a6c0424fa083/LightController_PCB/README.md

# LightController_PCB
This is the PCB (designed in KiCad) used in the LightController software
