a6c0424fa083/LightController_PCB/Projects/DMX-Adapter-small-V3/DMX-Adapter-small-V3.kicad_pcb

## KiCad design Projects/DMX-Adapter-small-V3/DMX-Adapter-small-V3.kicad_pcb (2025-03-28)

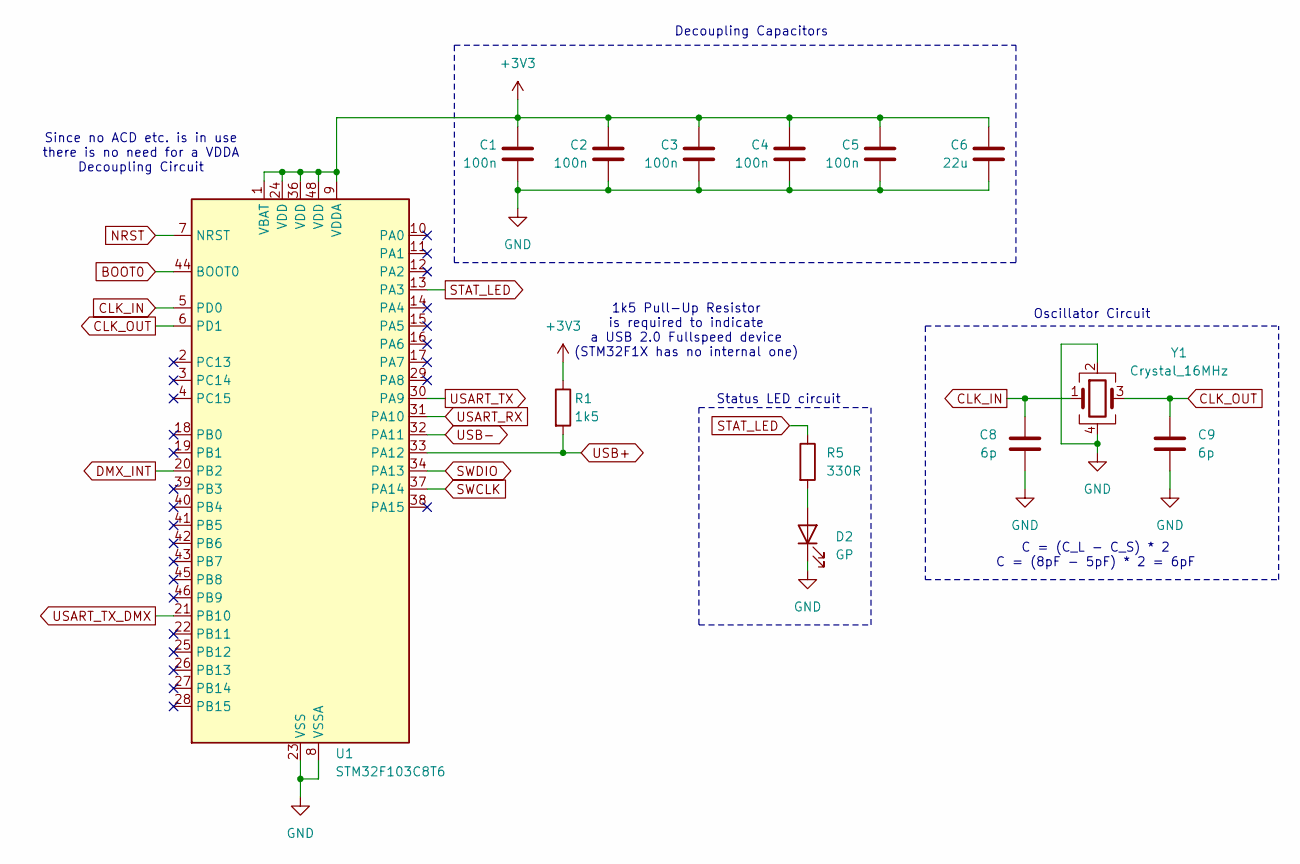
[picture p1: schematic mcu.kicad_sch]

Parts:
C1, C2, C3, C4, C5: 100n; C_0402_1005Metric; Mouser-Nr 81-GRM152D70G104ME5D
C6: 22u; C_0603_1608Metric; Mouser-Nr 81-GRM188C80J226ME5D
C8, C9: 6p; C_0402_1005Metric; Mouser-Nr 81-GCQ1555C1H6R0BB1D
D2: GP; D_0603_1608Metric; Mouser-Nr 755-SML-D12V8WT86
R1: 1k5; R_0402_1005Metric; Mouser-Nr 667-ERA-2VEB1501X
R5: 330R; R_0402_1005Metric; Mouser-Nr 71-CRCW0402330RFKEDH
U1: STM32F103C8T6; LQFP-48_7x7mm_P0.5mm; Mouser-Nr 511-STM32F103C8T6
Y1: Crystal_16MHz; Crystal_Wuerth_830108207109; Mouser-Nr 710-830108207109

Connections:
+3V3: C1.1, C2.1, C3.1, C4.1, C5.1, C6.1, R1.1, U1.1 (VBAT), U1.9 (VDDA), U1.24 (VDD), U1.36 (VDD), U1.48 (VDD); also elsewhere on the board
BOOT0: U1.44 (BOOT0); also elsewhere on the board
CLK_IN: C8.1, U1.5 (PD0), Y1.1
CLK_OUT: C9.1, U1.6 (PD1), Y1.3
DMX_INT: U1.20 (PB2); also elsewhere on the board
GND: C1.2, C2.2, C3.2, C4.2, C5.2, C6.2, C8.2, C9.2, D2.1 (K), U1.8 (VSSA), U1.23 (VSS), U1.35 (VSS), U1.47 (VSS), Y1.2, Y1.4; also elsewhere on the board
NRST: U1.7 (NRST); also elsewhere on the board
unnamed: D2.2 (A), R5.2
STAT_LED: R5.1, U1.13 (PA3)
SWCLK: U1.37 (PA14); also elsewhere on the board
SWDIO: U1.34 (PA13); also elsewhere on the board
USART_RX: U1.31 (PA10); also elsewhere on the board
USART_TX: U1.30 (PA9); also elsewhere on the board
USART_TX_DMX: U1.21 (PB10); also elsewhere on the board
USB+: R1.2, U1.33 (PA12); also elsewhere on the board
USB-: U1.32 (PA11); also elsewhere on the board

Notes on the sheet:
Status LED circuit
1k5 Pull-Up Resistor is required to indicate a USB 2.0 Fullspeed device (STM32F1X has no internal one)
Oscillator Circuit
Decoupling Capacitors
C = (C_L - C_S) * 2 C = (8pF - 5pF) * 2 = 6pF
Since no ACD etc. is in use there is no need for a VDDA Decoupling Circuit

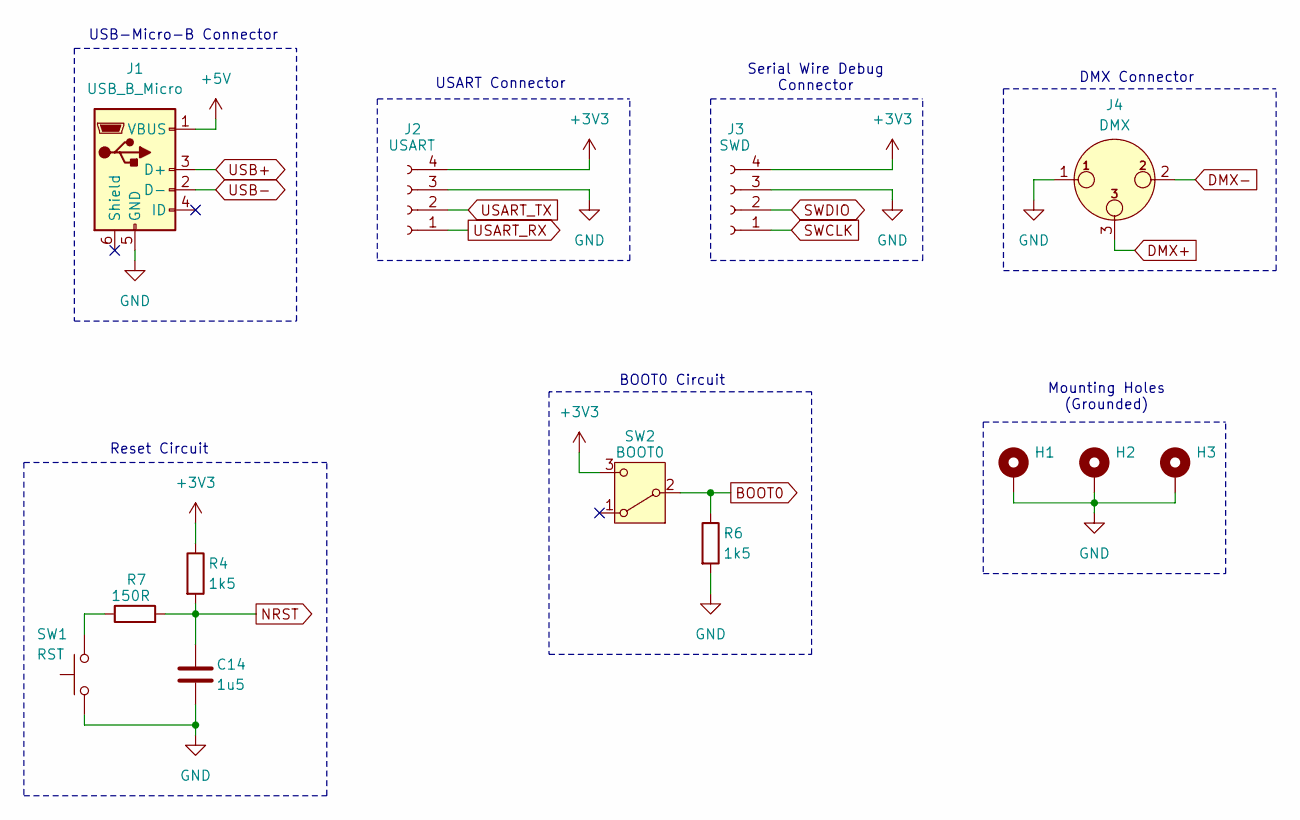
[picture p2: schematic connectors_io.kicad_sch, Connectors & IO]

Parts:
C14: 1u5; C_0603_1608Metric; Mouser-Nr 810-C1608X8L0J155K08
H1, H2, H3: MountingHole_Pad; MountingHole_2.2mm_M2_Pad
J1: USB_B_Micro; USB_Micro-B_Wuerth_629105150521; Mouser-Nr 710-629105150521
J2: USART; PinSocket_1x04_P2.54mm_Vertical; Mouser-Nr 710-61300411821
J3: SWD; PinSocket_1x04_P2.54mm_Vertical; Mouser-Nr 710-61300411821
J4: DMX; XLR3_Female; Mouser-Nr 568-NC3FAAH-1
R4, R6: 1k5; R_0402_1005Metric; Mouser-Nr 667-ERA-2VEB1501X
R7: 150R; R_0402_1005Metric; Mouser-Nr 660-SG73P1EWTTP151J
SW1: RST; omron_B3U-1000P; Mouser-Nr 653-B3U-1000P
SW2: BOOT0; wuerth_slide_switch_450404015514; Mouser-Nr 710-450404015514

Connections:
+3V3: J2.4, J3.4, R4.1, SW2.3 (C); also elsewhere on the board
+5V: J1.1 (VBUS); also elsewhere on the board
BOOT0: R6.1, SW2.2 (B); also elsewhere on the board
DMX+: J4.3; also elsewhere on the board
DMX-: J4.2; also elsewhere on the board
GND: C14.2, H1.1, H2.1, H3.1, J1.5 (GND), J2.3, J3.3, J4.1, R6.2, SW1.1; also elsewhere on the board
NRST: C14.1, R4.2, R7.2; also elsewhere on the board
unnamed: R7.1, SW1.2
SWCLK: J3.1; also elsewhere on the board
SWDIO: J3.2; also elsewhere on the board
USART_RX: J2.1; also elsewhere on the board
USART_TX: J2.2; also elsewhere on the board
USB+: J1.3 (D+); also elsewhere on the board
USB-: J1.2 (D-); also elsewhere on the board

Notes on the sheet:
Reset Circuit
USART Connector
USB-Micro-B Connector
Serial Wire Debug Connector
Mounting Holes (Grounded)
DMX Connector
BOOT0 Circuit

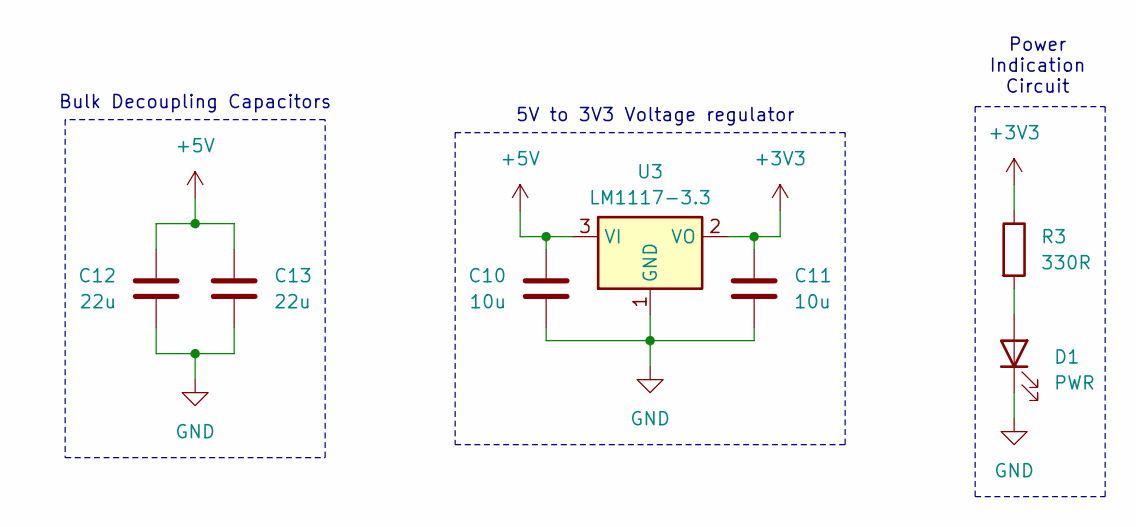
[picture p3: schematic power.kicad_sch]

Parts:
C10, C11: 10u; C_0805_2012Metric; Mouser-Nr 581-TACR106M006RTA
C12, C13: 22u; C_0603_1608Metric; Mouser-Nr 81-GRM188C80J226ME5D
D1: PWR; D_0603_1608Metric; Mouser-Nr 755-SML-D12V8WT86
R3: 330R; R_0402_1005Metric; Mouser-Nr 71-CRCW0402330RFKEDH
U3: LM1117-3.3; SOT-223-3_TabPin2; Mouser-Nr 926-LM1117IMPX33NOPB

Connections:
+3V3: C11.1, R3.1, U3.2 (VO); also elsewhere on the board
+5V: C10.1, C12.1, C13.1, U3.3 (VI); also elsewhere on the board
GND: C10.2, C11.2, C12.2, C13.2, D1.1 (K), U3.1 (GND); also elsewhere on the board
unnamed: D1.2 (A), R3.2

Notes on the sheet:
Power Indication Circuit
5V to 3V3 Voltage regulator
Bulk Decoupling Capacitors

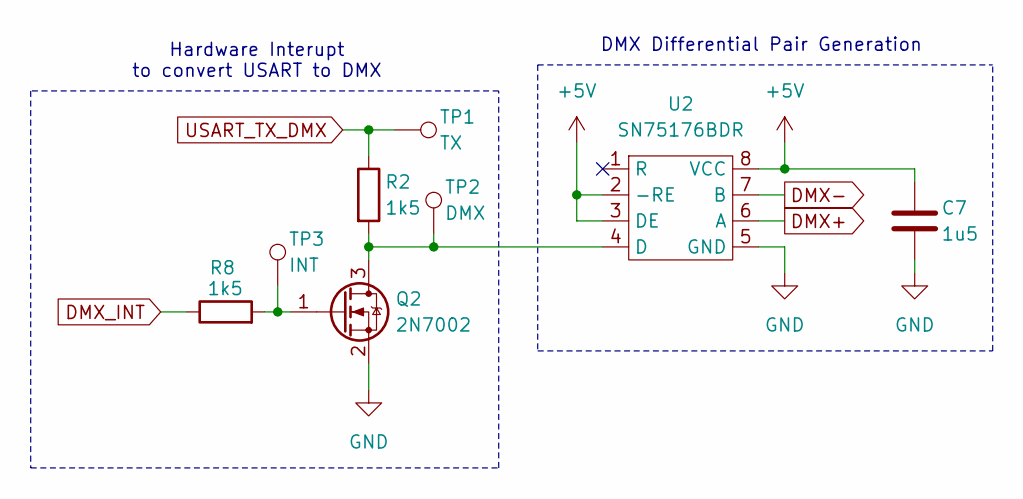
[picture p4: schematic dmx_circuit.kicad_sch, DMX-Circuit]

Parts:
C7: 1u5; C_0603_1608Metric; Mouser-Nr 810-C1608X8L0J155K08
Q2: 2N7002; SOT-23-3; Mouser-Nr 512-2N7002
R2, R8: 1k5; R_0402_1005Metric; Mouser-Nr 667-ERA-2VEB1501X
TP1: TX; TestPoint_Pad_D1.0mm
TP2: DMX; TestPoint_Pad_D1.0mm
TP3: INT; TestPoint_Pad_D1.0mm
U2: SN75176BDR; SN75176B-SOIC-8; Mouser-Nr 595-SN75176BDR

Connections:
+5V: C7.1, U2.2 (-RE), U2.3 (DE), U2.8 (VCC); also elsewhere on the board
DMX+: U2.6 (A); also elsewhere on the board
DMX-: U2.7 (B); also elsewhere on the board
DMX_INT: R8.1; also elsewhere on the board
GND: C7.2, Q2.2 (S), U2.5 (GND); also elsewhere on the board
unnamed: Q2.3 (D), R2.2, TP2.1, U2.4 (D)
unnamed: Q2.1 (G), R8.2, TP3.1
USART_TX_DMX: R2.1, TP1.1; also elsewhere on the board

Notes on the sheet:
DMX Differential Pair Generation
Hardware Interupt to convert USART to DMX

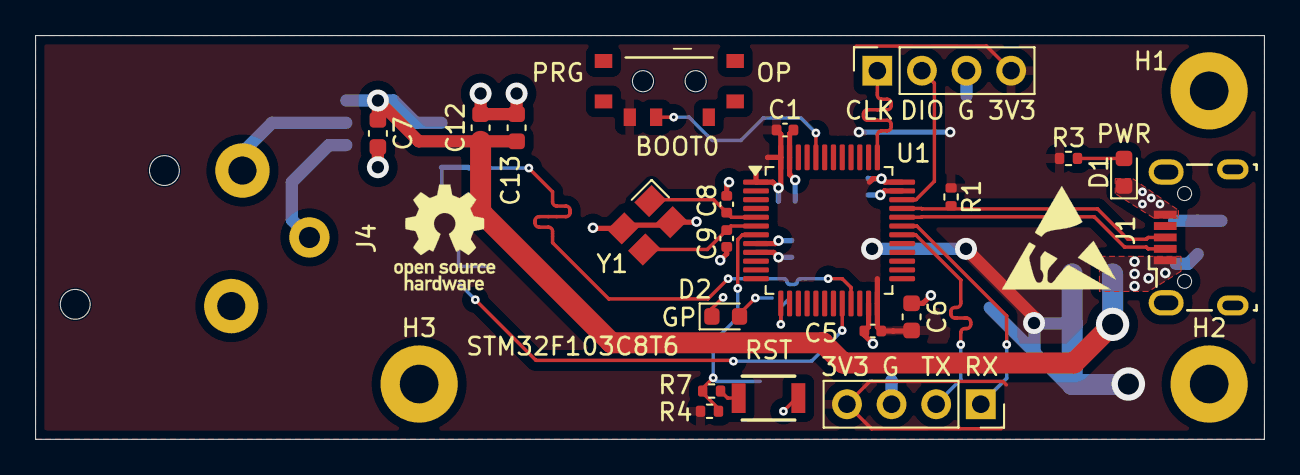
[picture p5: board DMX-Adapter-small-V3.kicad_pcb from above]

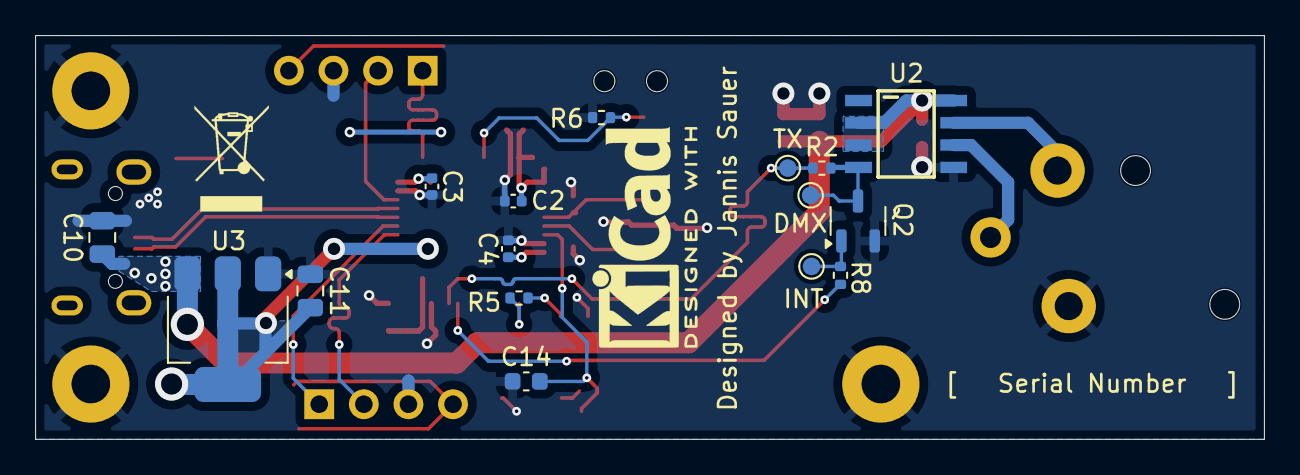
[picture p6: board DMX-Adapter-small-V3.kicad_pcb from below]

Board: 2 copper layers, 70.0 x 23.0 mm, 41 parts (16 on the bottom side), 23 nets.
